zhiayang/mikoto/flashbed/mikoto-flashbed.kicad_pcb

## KiCad design flashbed/mikoto-flashbed.kicad_pcb (2022-01-12)

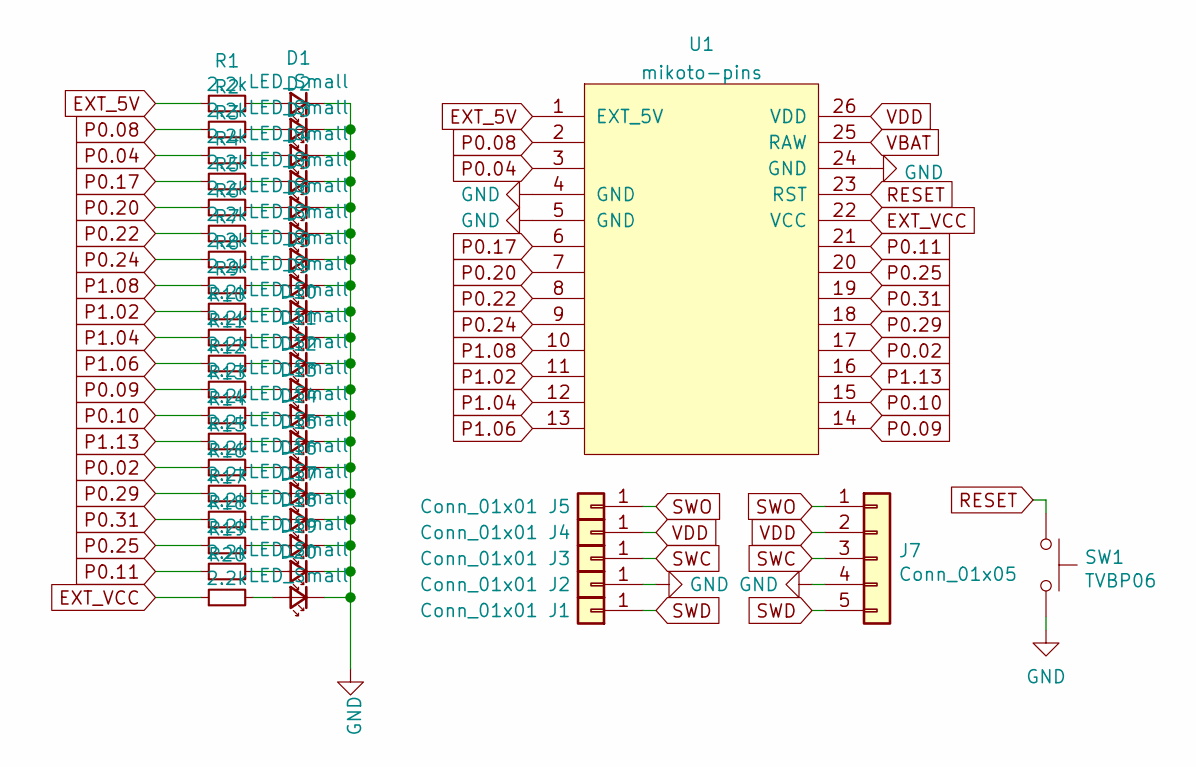
[picture p4: schematic mikoto-flashbed.kicad_sch]

Parts:
D1, D2, D3, D4, D5, D6, D7, D8, D9, D10, D11, D12, D13, D14, D15, D16, D17, D18, D19, D20: LED_Small; LED_1206_3216M_Castellated-nosilk
J1, J2, J3, J4, J5: Conn_01x01; TestPoint_THTPad_D2.0mm_Drill1.0mm
J7: Conn_01x05; PinHeader_1x05_P2.54mm_Horizontal
R1, R2, R3, R4, R5, R6, R7, R8, R9, R10, R11, R12, R13, R14, R15, R16, R17, R18, R19, R20: 2.2k; R_0805_2012Metric_Pad1.15x1.40mm_HandSolder
SW1: TVBP06; TACT_SWITCH_TVBP06
U1: mikoto-pins

Connections:
EXT_5V: R1.1, U1.1 (EXT_5V)
EXT_VCC: R20.1, U1.22 (VCC)
GND: D1.1 (K), D2.1 (K), D3.1 (K), D4.1 (K), D5.1 (K), D6.1 (K), D7.1 (K), D8.1 (K), D9.1 (K), D10.1 (K), D11.1 (K), D12.1 (K), D13.1 (K), D14.1 (K), D15.1 (K), D16.1 (K), D17.1 (K), D18.1 (K), D19.1 (K), D20.1 (K), J2.1, J7.4, SW1.2, U1.4 (GND), U1.5 (GND), U1.24 (GND)
unnamed: D1.2 (A), R1.2
unnamed: D2.2 (A), R2.2
unnamed: D3.2 (A), R3.2
unnamed: D4.2 (A), R4.2
unnamed: D5.2 (A), R5.2
unnamed: D6.2 (A), R6.2
unnamed: D7.2 (A), R7.2
unnamed: D8.2 (A), R8.2
unnamed: D9.2 (A), R9.2
unnamed: D10.2 (A), R10.2
unnamed: D11.2 (A), R11.2
unnamed: D12.2 (A), R12.2
unnamed: D13.2 (A), R13.2
unnamed: D14.2 (A), R14.2
unnamed: D15.2 (A), R15.2
unnamed: D16.2 (A), R16.2
unnamed: D17.2 (A), R17.2
unnamed: D18.2 (A), R18.2
unnamed: D19.2 (A), R19.2
unnamed: D20.2 (A), R20.2
P0.02: R15.1, U1.17
P0.04: R3.1, U1.3
P0.08: R2.1, U1.2
P0.09: R12.1, U1.14
P0.10: R13.1, U1.15
P0.11: R19.1, U1.21
P0.17: R4.1, U1.6
P0.20: R5.1, U1.7
P0.22: R6.1, U1.8
P0.24: R7.1, U1.9
P0.25: R18.1, U1.20
P0.29: R16.1, U1.18
P0.31: R17.1, U1.19
P1.02: R9.1, U1.11
P1.04: R10.1, U1.12
P1.06: R11.1, U1.13
P1.08: R8.1, U1.10
P1.13: R14.1, U1.16
RESET: SW1.1, U1.23 (RST)
SWC: J3.1, J7.3
SWD: J1.1, J7.5
SWO: J5.1, J7.1
VBAT: U1.25 (RAW)
VDD: J4.1, J7.2, U1.26 (VDD)

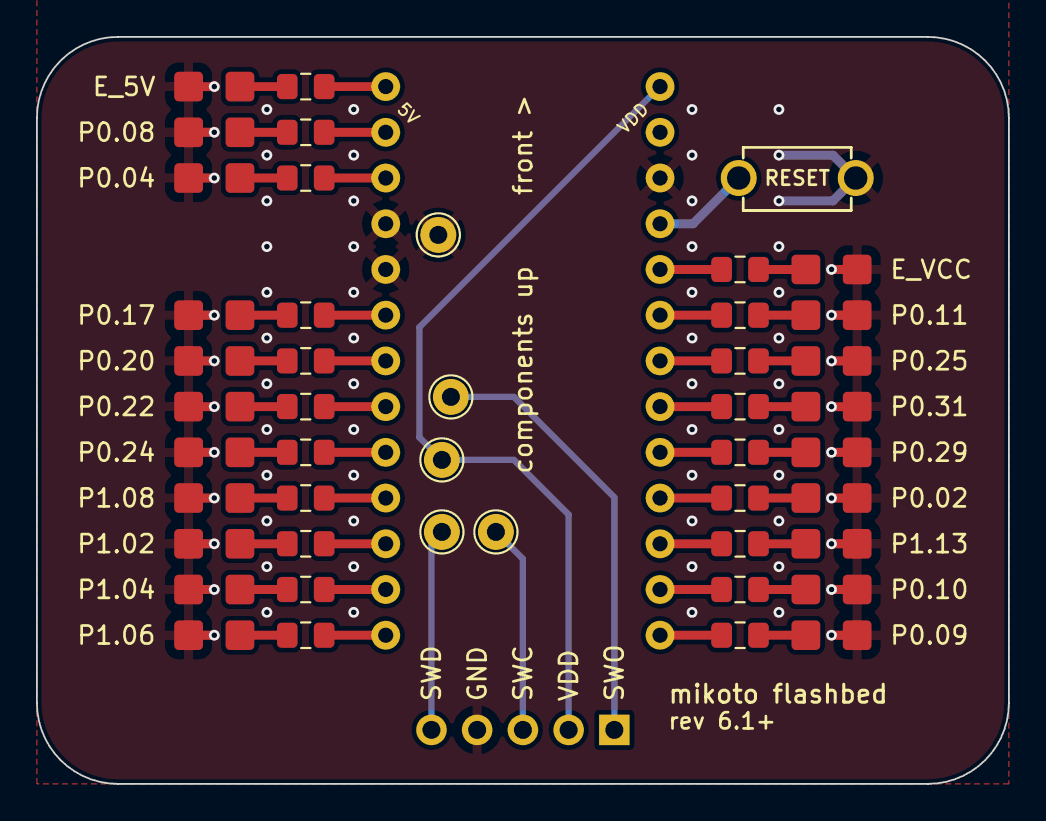
[picture p5: board mikoto-flashbed.kicad_pcb from above]

Board: 2 copper layers, 54.0 x 41.5 mm, 48 parts (1 on the bottom side), 46 nets.
