zhiayang/mikoto/akami.kicad_pcb

## KiCad design akami.kicad_pcb (2021-01-29)

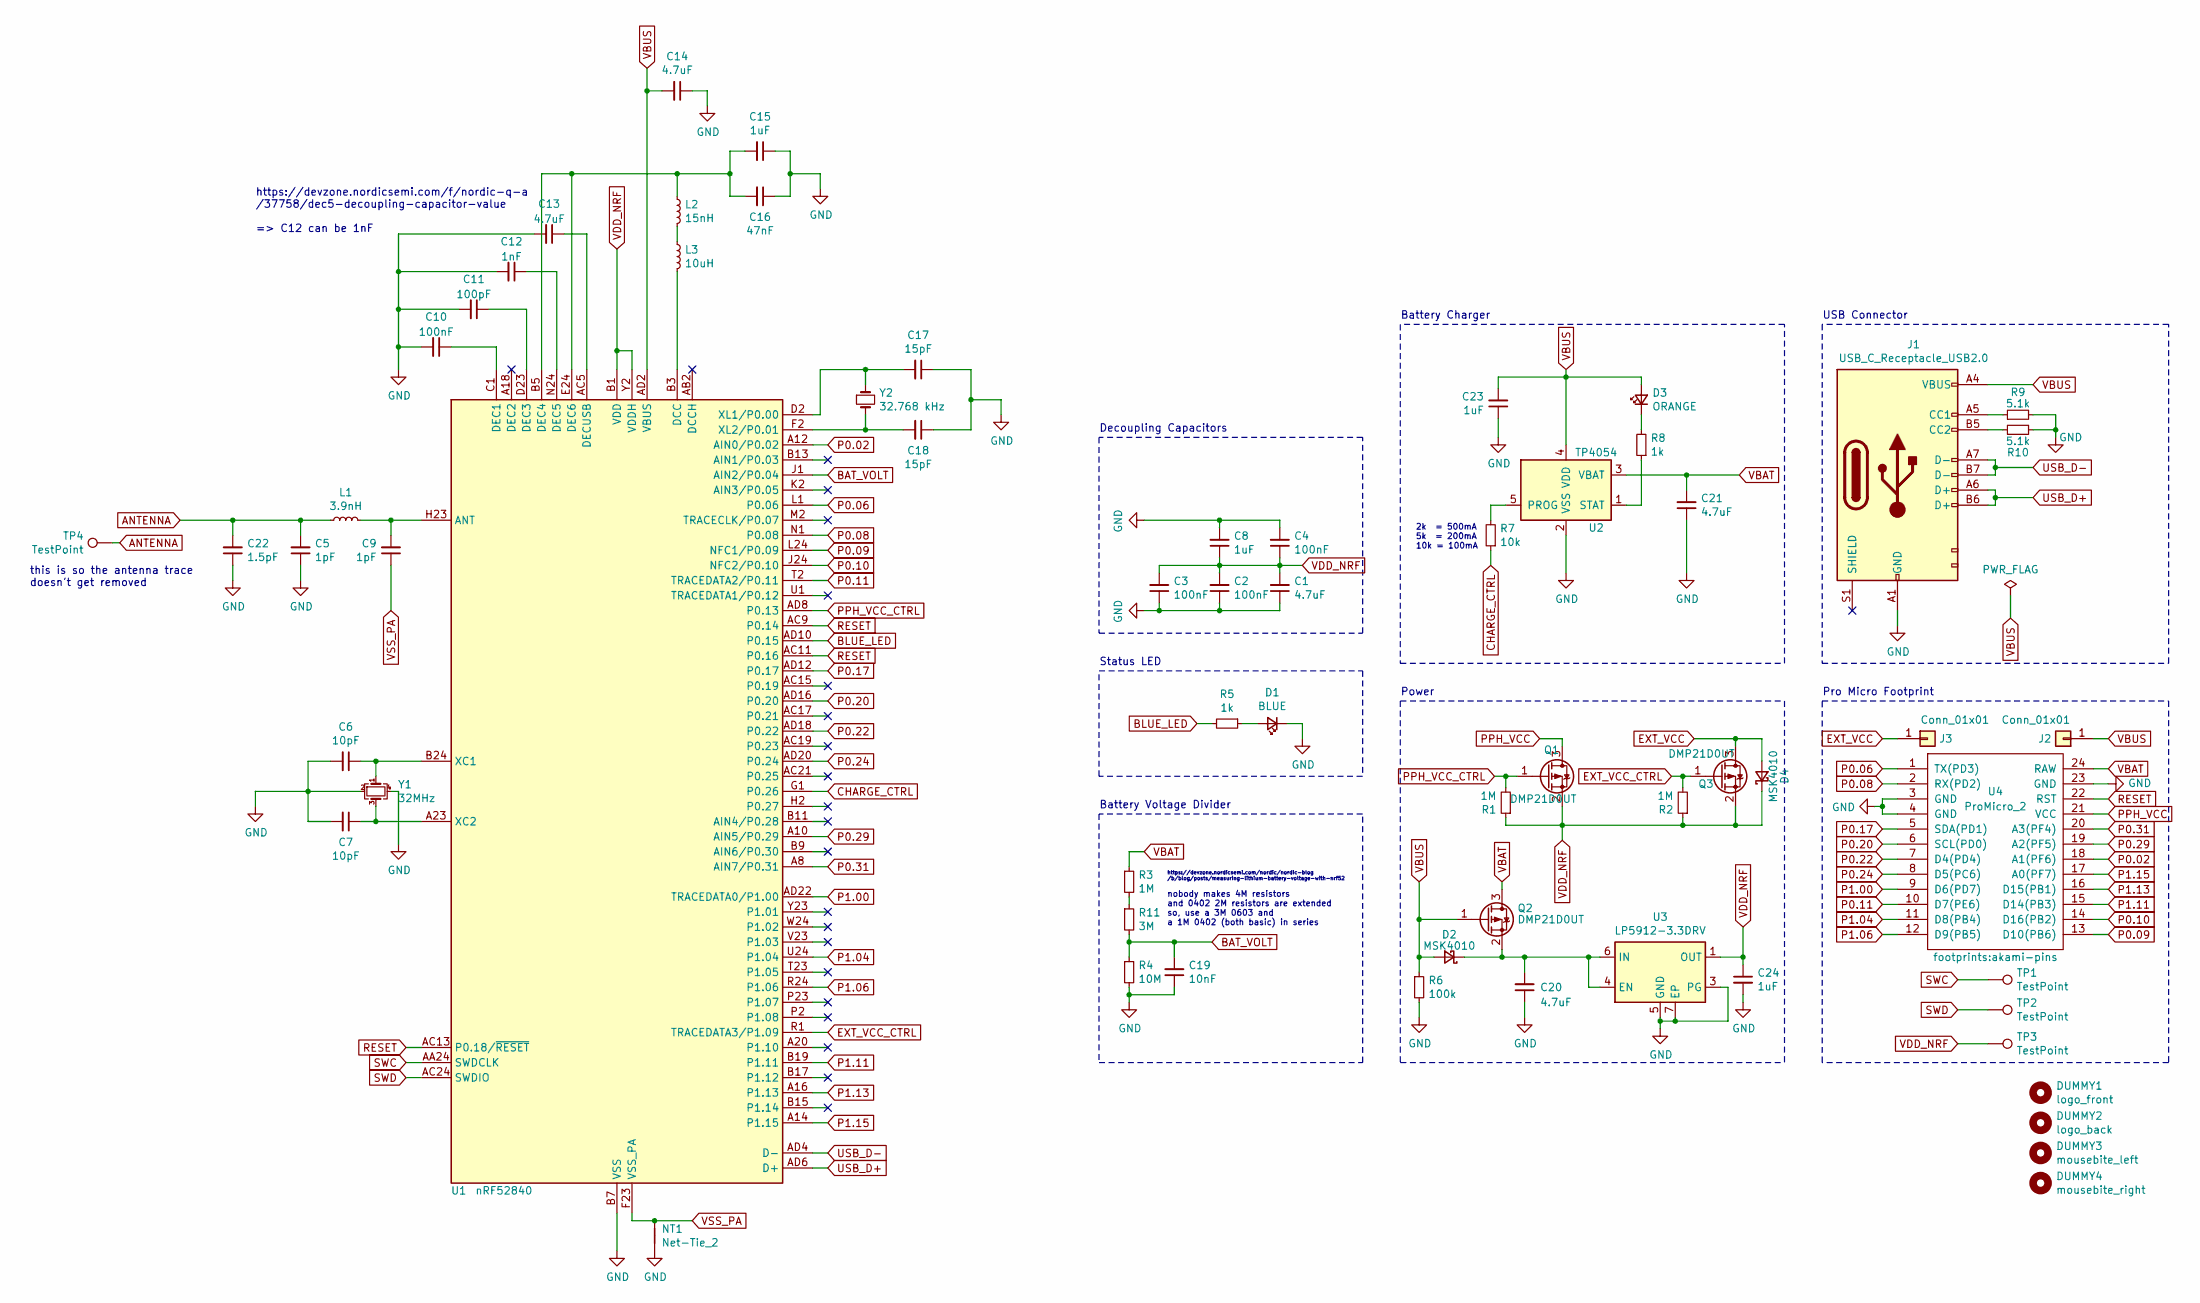
[picture p6: schematic akami.sch]

Parts:
C1, C13, C14, C20, C21: 4.7uF; C_0603_1608Metric; LCSC Part C19666
C2, C3, C4, C10: 100nF; C_0402_1005Metric; LCSC Part C1525
C5, C9: 1pF; C_0402_1005Metric; LCSC Part C1550
C6, C7: 10pF; C_0402_1005Metric; LCSC Part C32949
C8, C15, C23, C24: 1uF; C_0402_1005Metric; LCSC Part C52923
C11: 100pF; C_0402_1005Metric; LCSC Part C1546
C12: 1nF; C_0402_1005Metric; LCSC Part C1523
C16: 47nF; C_0603_1608Metric; LCSC Part C1622
C17, C18: 15pF; C_0402_1005Metric; LCSC Part C1548
C19: 10nF; C_0402_1005Metric; LCSC Part C15195
C22: 1.5pF; C_0402_1005Metric; LCSC Part C1552
D1: BLUE; LED_0603_1608Metric; LCSC Part C72041
D2, D4: MSK4010; D_SOD-523; LCSC Part C345958
D3: ORANGE; LED_0603_1608Metric; LCSC Part C2286
DUMMY1: logo_front; akami-logo
DUMMY2: logo_back; akami-logo
DUMMY3: mousebite_left; mouse-bite-2mm-slot-one-sided
DUMMY4: mousebite_right; mouse-bite-2mm-slot-one-sided
J1: USB_C_Receptacle_USB2.0; USB-C_C168688
J2, J3: Conn_01x01; 1pin_conn
L1: 3.9nH; L_0402_1005Metric; LCSC Part C14033
L2: 15nH; L_0402_1005Metric; LCSC Part C27143
L3: 10uH; L_0603_1608Metric; LCSC Part C1035
NT1: Net-Tie_2; net-tie-2-tiny
Q1, Q2, Q3: DMP21D0UT; SOT-523; LCSC Part C150733
R1, R2, R3: 1M; R_0402_1005Metric; LCSC Part C26083
R4: 10M; R_0402_1005Metric; LCSC Part C26082
R5, R8: 1k; R_0402_1005Metric; LCSC Part C11702
R6: 100k; R_0402_1005Metric; LCSC Part C25741
R7: 10k; R_0402_1005Metric; LCSC Part C25744
R9, R10: 5.1k; R_0402_1005Metric; LCSC Part C25905
R11: 3M; R_0603_1608Metric; LCSC Part C23156
TP1, TP2, TP3: TestPoint; TestPoint_Pad_1.0x1.0mm
TP4: TestPoint; circular-pad-0.3mm
U1: nRF52840; Nordic_AQFN-73-1EP_7x7mm_P0.5mm; LCSC Part C190794
U2: TP4054; SOT-23-5; LCSC Part C32574
U3: LP5912-3.3DRV; WSON-6-1EP_2x2mm_P0.65mm_EP1x1.6mm_ThermalVias; LCSC Part C134121
U4: ProMicro_2; akami-pins
Y1: 32MHz; Crystal_SMD_2016-4Pin_2.0x1.6mm; LCSC Part C254298
Y2: 32.768 kHz; Crystal_SMD_3215-2Pin_3.2x1.5mm; LCSC Part C32346

Connections:
ANTENNA: C5.2, C22.2, L1.1, TP4.1
BAT_VOLT: C19.2, R4.1, R11.2, U1.J1 (AIN2/P0.04)
BLUE_LED: R5.2, U1.AD10 (P0.15)
CHARGE_CTRL: R7.1, U1.G1 (P0.26)
EXT_VCC: D4.2 (A), J3.1, Q3.3 (D)
EXT_VCC_CTRL: Q3.1 (G), R2.2, U1.R1 (TRACEDATA3/P1.09)
GND: C1.1, C2.1, C3.1, C4.2, C5.1, C6.2, C7.2, C8.2, C10.2, C11.2, C12.2, C13.2, C14.1, C15.1, C16.1, C17.1, C18.1, C19.1, C20.1, C21.1, C22.1, C23.1, C24.2, D1.1 (K), J1.A1 (GND), NT1.2, R4.2, R6.2, R9.2, R10.2, U1.B7 (VSS), U1.EP (VSS), U2.2 (VSS), U3.3 (PG), U3.5 (GND), U3.7 (EP), U4.3 (GND), U4.4 (GND), U4.23 (GND), Y1.2, Y1.4
unnamed: C6.1, U1.B24 (XC1), Y1.1
unnamed: C7.1, U1.A23 (XC2), Y1.3
unnamed: C9.2, L1.2, U1.H23 (ANT)
unnamed: C10.1, U1.C1 (DEC1)
unnamed: C11.1, U1.D23 (DEC3)
unnamed: C12.1, U1.N24 (DEC5)
unnamed: C13.1, U1.AC5 (DECUSB)
unnamed: C15.2, C16.2, L2.1, U1.B5 (DEC4), U1.E24 (DEC6)
unnamed: C17.2, U1.D2 (XL1/P0.00), Y2.1
unnamed: C18.2, U1.F2 (XL2/P0.01), Y2.2
unnamed: C20.2, D2.1 (K), Q2.2 (S), U3.4 (EN), U3.6 (IN)
unnamed: D1.2 (A), R5.1
unnamed: D3.1 (K), R8.2
unnamed: J1.A5 (CC1), R9.1
unnamed: J1.B5 (CC2), R10.1
unnamed: L2.2, L3.1
unnamed: L3.2, U1.B3 (DCC)
unnamed: R7.2, U2.5 (PROG)
unnamed: R8.1, U2.1 (STAT)
unnamed: R3.2, R11.1
P0.02: U1.A12 (AIN0/P0.02), U4.18 (A1(PF6))
P0.06: U1.L1 (P0.06), U4.1 (TX(PD3))
P0.08: U1.N1 (P0.08), U4.2 (RX(PD2))
P0.09: U1.L24 (NFC1/P0.09), U4.13 (D10(PB6))
P0.10: U1.J24 (NFC2/P0.10), U4.14 (D16(PB2))
P0.11: U1.T2 (TRACEDATA2/P0.11), U4.10 (D7(PE6))
P0.17: U1.AD12 (P0.17), U4.5 (SDA(PD1))
P0.20: U1.AD16 (P0.20), U4.6 (SCL(PD0))
P0.22: U1.AD18 (P0.22), U4.7 (D4(PD4))
P0.24: U1.AD20 (P0.24), U4.8 (D5(PC6))
P0.29: U1.A10 (AIN5/P0.29), U4.19 (A2(PF5))
P0.31: U1.A8 (AIN7/P0.31), U4.20 (A3(PF4))
P1.00: U1.AD22 (TRACEDATA0/P1.00), U4.9 (D6(PD7))
P1.04: U1.U24 (P1.04), U4.11 (D8(PB4))
P1.06: U1.R24 (P1.06), U4.12 (D9(PB5))
P1.11: U1.B19 (P1.11), U4.15 (D14(PB3))
P1.13: U1.A16 (P1.13), U4.16 (D15(PB1))
P1.15: U1.A14 (P1.15), U4.17 (A0(PF7))
PPH_VCC: Q1.3 (D), U4.21 (VCC)
PPH_VCC_CTRL: Q1.1 (G), R1.2, U1.AD8 (P0.13)
RESET: U1.AC9 (P0.14), U1.AC11 (P0.16), U1.AC13 (P0.18/~RESET), U4.22 (RST)
SWC: TP1.1, U1.AA24 (SWDCLK)
SWD: TP2.1, U1.AC24 (SWDIO)
USB_D+: J1.A6 (D+), J1.B6 (D+), U1.AD6 (D+)
USB_D-: J1.A7 (D-), J1.B7 (D-), U1.AD4 (D-)
VBAT: C21.2, Q2.3 (D), R3.1, U2.3 (VBAT), U4.24 (RAW)
VBUS: C14.2, C23.2, D2.2 (A), D3.2 (A), J1.A4 (VBUS), J2.1, Q2.1 (G), R6.1, U1.AD2 (VBUS), U2.4 (VDD)
VDD_NRF: C1.2, C2.2, C3.2, C4.1, C8.1, C24.1, D4.1 (K), Q1.2 (S), Q3.2 (S), R1.1, R2.1, TP3.1, U1.A22 (VDD), U1.AD14 (VDD), U1.AD23 (VDD), U1.B1 (VDD), U1.W1 (VDD), U1.Y2 (VDDH), U3.1 (OUT)
VSS_PA: C9.1, NT1.1, U1.F23 (VSS_PA)

Notes on the sheet:
2k = 500mA 5k = 200mA 10k = 100mA
https://devzone.nordicsemi.com/nordic/nordic-blog /b/blog/posts/measuring-lithium-battery-voltage-with-nrf52
nobody makes 4M resistors and 0402 2M resistors are extended so, use a 3M 0603 and a 1M 0402 (both basic) in series
this is so the antenna trace doesn't get removed
Pro Micro Footprint
USB Connector
Battery Charger
Status LED
Battery Voltage Divider
Decoupling Capacitors
https://devzone.nordicsemi.com/f/nordic-q-a /37758/dec5-decoupling-capacitor-value => C12 can be 1nF
Power

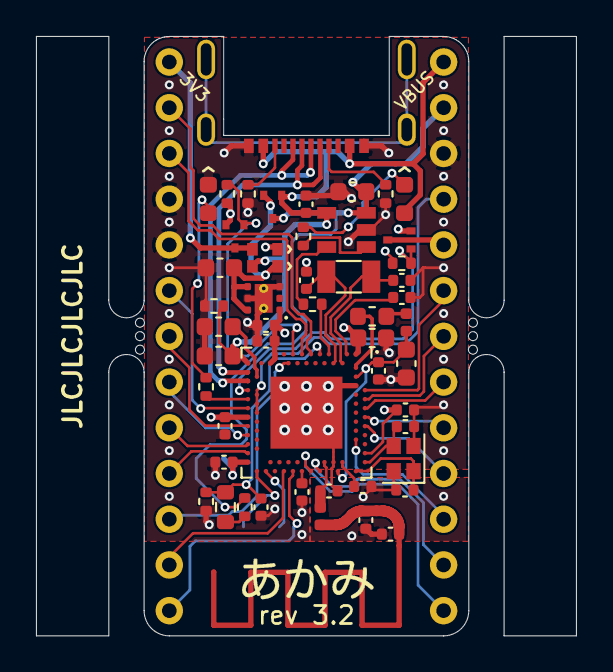
[picture p7: board akami.kicad_pcb from above]

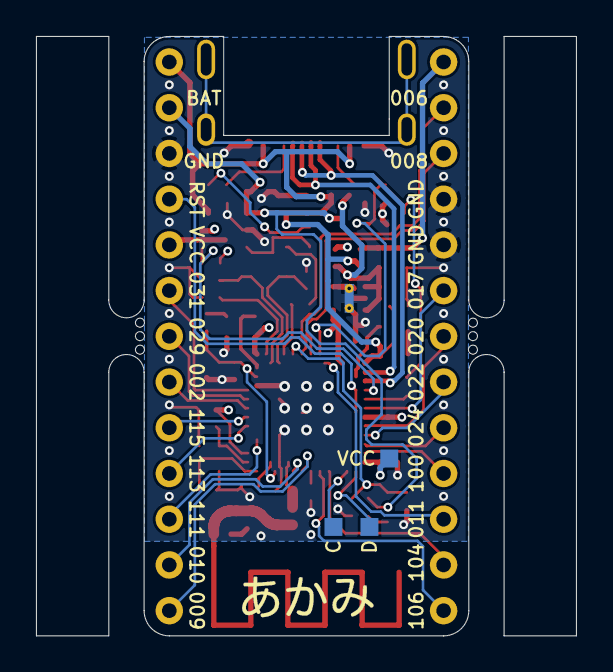
[picture p8: board akami.kicad_pcb from below]

Board: 4 copper layers, 30.0 x 33.3 mm, 63 parts (4 on the bottom side), 56 nets.
